MK040412/AlohaMini/docs/media/assembly/10.jpg

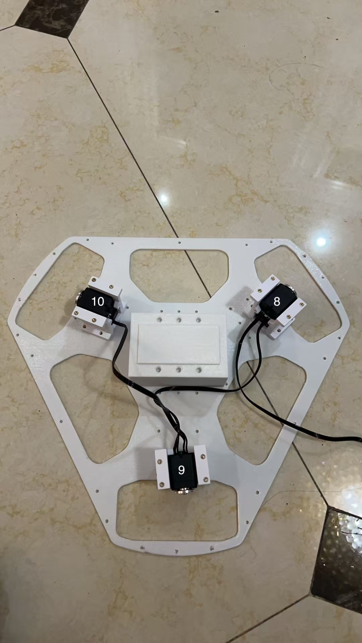
docs/media/assembly/10.jpg
