MK040412/AlohaMini/hardware/mobile_base/stl/O_Main_Assembly_Post4.stl

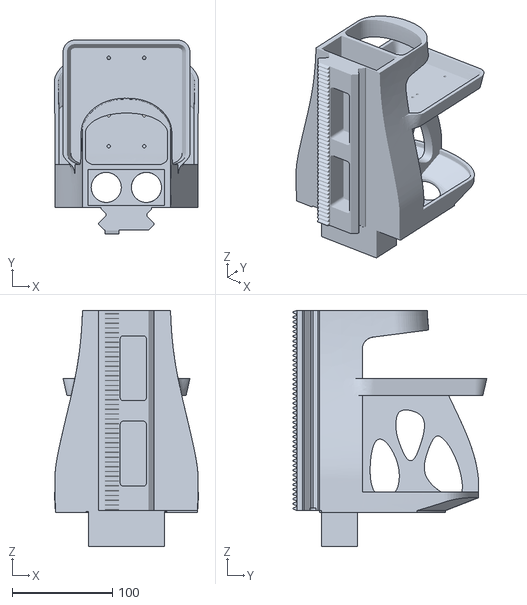
[picture p2: CAD file, 2025-12-03]
hardware/mobile_base/stl/O_Main_Assembly_Post4.stl
143.8 x 192.8 x 235.0
