MK040412/AlohaMini/hardware/mobile_base/step/O_Main_Assembly_Post3.stp

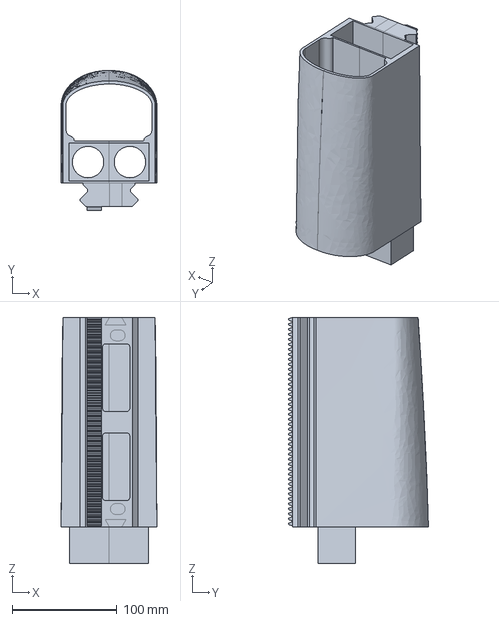
[picture p3: CAD file, 2025-11-27]
hardware/mobile_base/step/O_Main_Assembly_Post3.stp
91.5 x 133.6 x 235.0 mm
