MK040412/AlohaMini/hardware/mobile_base/step/OB_Main_Monitor_Connector.stp

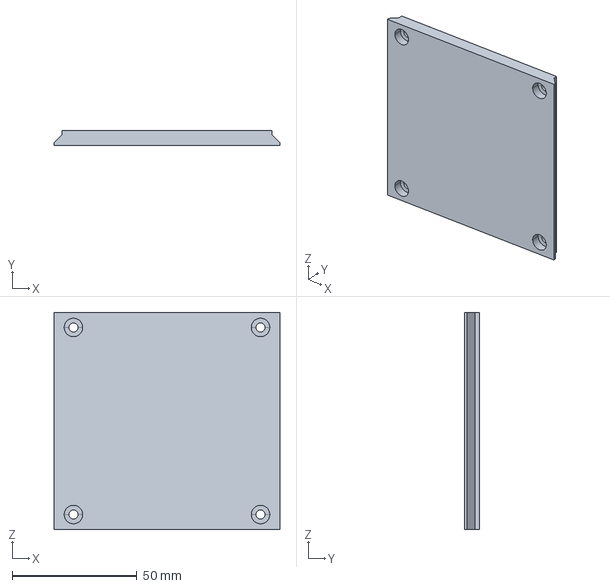
[picture p4: CAD file, 2025-11-27]
hardware/mobile_base/step/OB_Main_Monitor_Connector.stp
90.6 x 6.00 x 87.0 mm
