MK040412/AlohaMini/hardware/mobile_base/step/O_Main_Assembly_Post2.stp

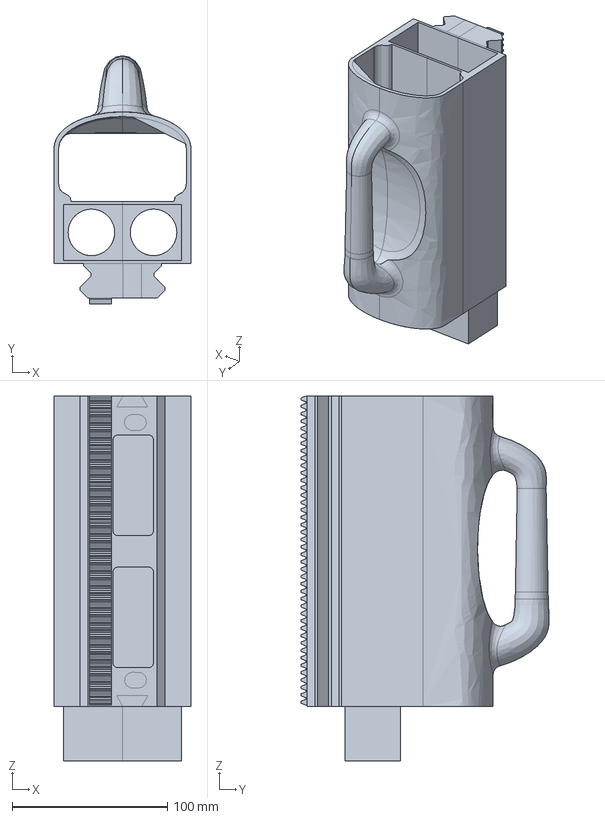
[picture p5: CAD file, 2025-11-27]
hardware/mobile_base/step/O_Main_Assembly_Post2.stp
88.1 x 159.9 x 235.0 mm
