MK040412/AlohaMini/hardware/mobile_base/step/O_Main_Assembly_Post1.stp

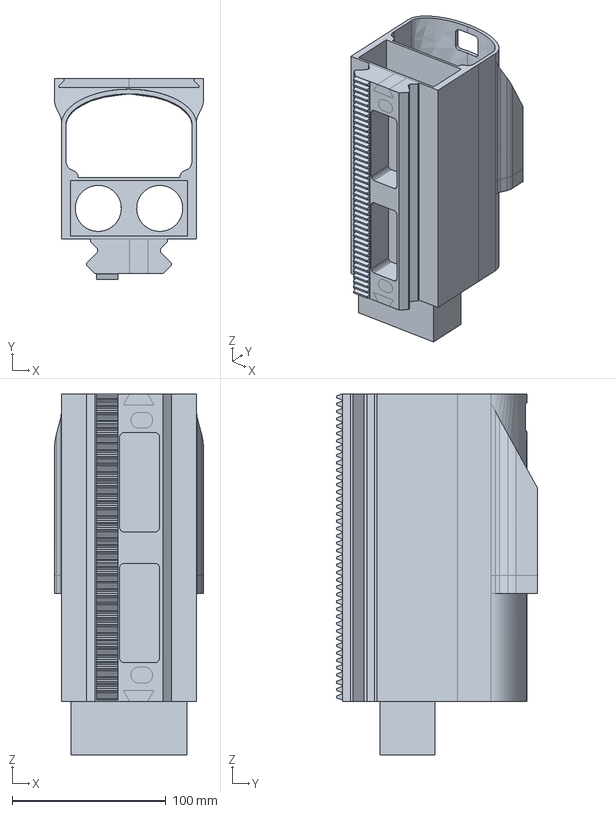
[picture p6: CAD file, 2025-11-27]
hardware/mobile_base/step/O_Main_Assembly_Post1.stp
97.0 x 130.7 x 235.0 mm
