MK040412/AlohaMini/hardware/mobile_base/step/O_Chassis_Dowel_Pin_12_37.stp

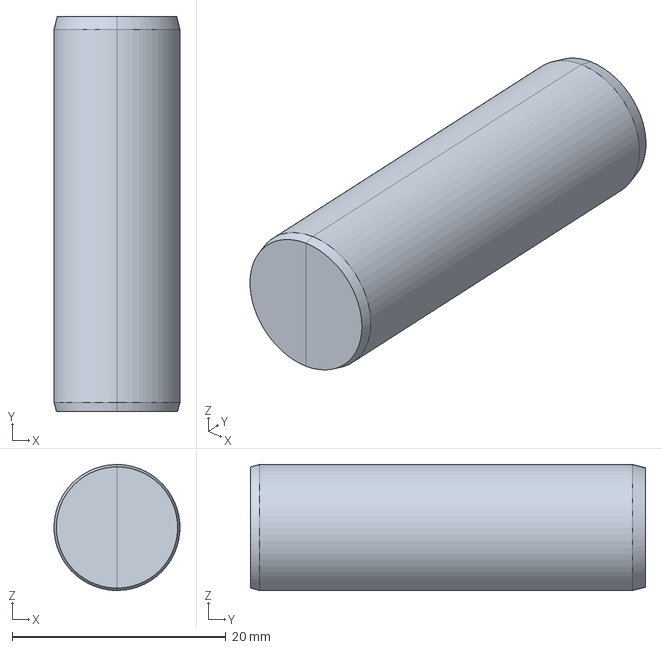
[picture p7: CAD file, 2025-11-27]
hardware/mobile_base/step/O_Chassis_Dowel_Pin_12_37.stp
11.8 x 37.0 x 11.8 mm
