MK040412/AlohaMini/maniskill/aloha_mini/meshes/left_link3.STL

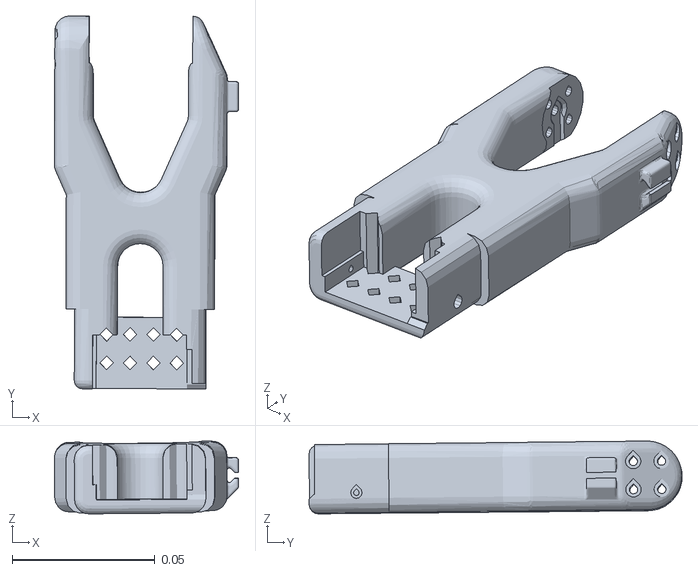
[picture p8: CAD file, 2025-12-24]
maniskill/aloha_mini/meshes/left_link3.STL
0.0646 x 0.131 x 0.0255
