MK040412/AlohaMini/hardware/mobile_base/step/OB_Z_Axis_Servo_Mount.stp

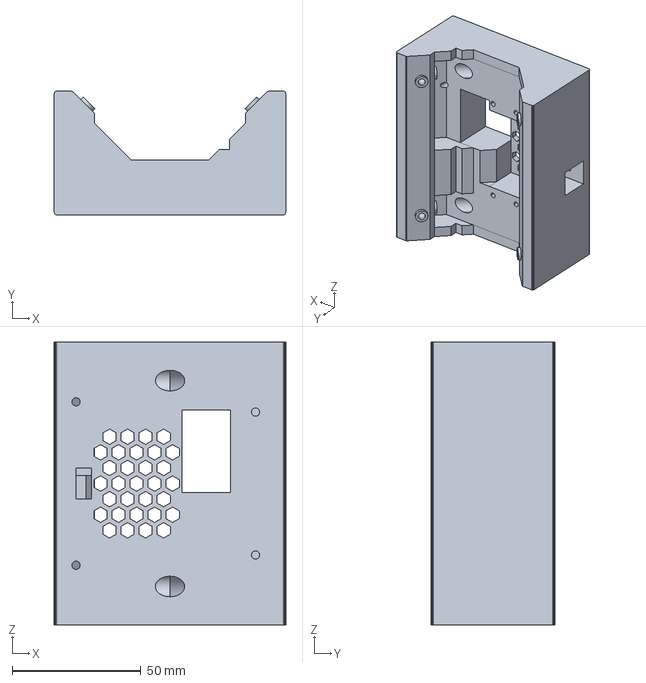
[picture p10: CAD file, 2025-11-27]
hardware/mobile_base/step/OB_Z_Axis_Servo_Mount.stp
90.0 x 48.0 x 110.0 mm
