MK040412/AlohaMini/maniskill/aloha_mini/meshes/wheel1.STL

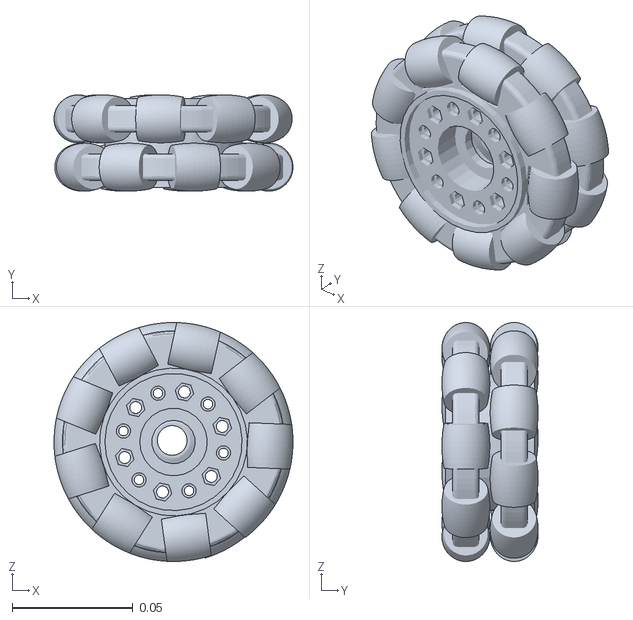
[picture p11: CAD file, 2025-12-24]
maniskill/aloha_mini/meshes/wheel1.STL
0.099 x 0.0399 x 0.099
