MK040412/AlohaMini/maniskill/assets/robots/aloha_mini/so100_meshes/Rotation_Pitch.stl.convex.stl

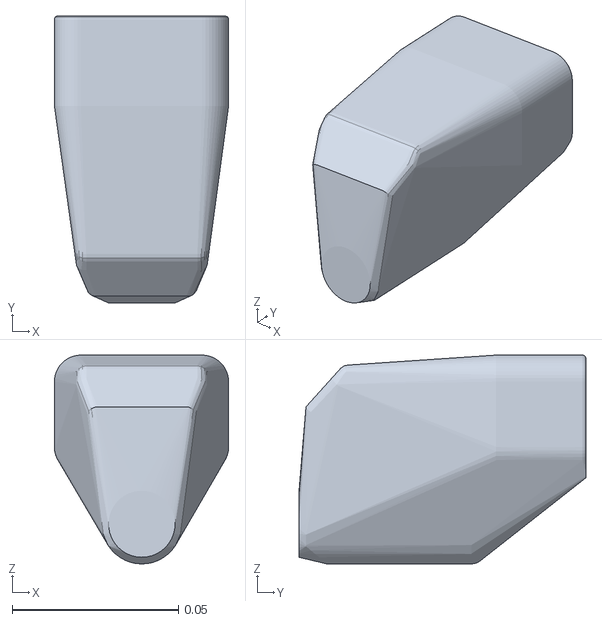
[picture p12: CAD file, 2026-01-14]
maniskill/assets/robots/aloha_mini/so100_meshes/Rotation_Pitch.stl.convex.stl
0.0524 x 0.0863 x 0.0628
