MK040412/AlohaMini/hardware/mobile_base/step/OB_Z_Axis_Bracket.stp

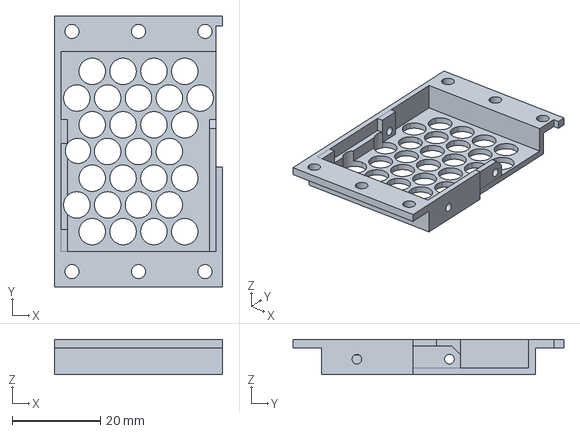
[picture p13: CAD file, 2025-11-27]
hardware/mobile_base/step/OB_Z_Axis_Bracket.stp
38.2 x 61.5 x 8.00 mm
