MK040412/AlohaMini/hardware/mobile_base/step/OB_T_Camera_Mount.stp

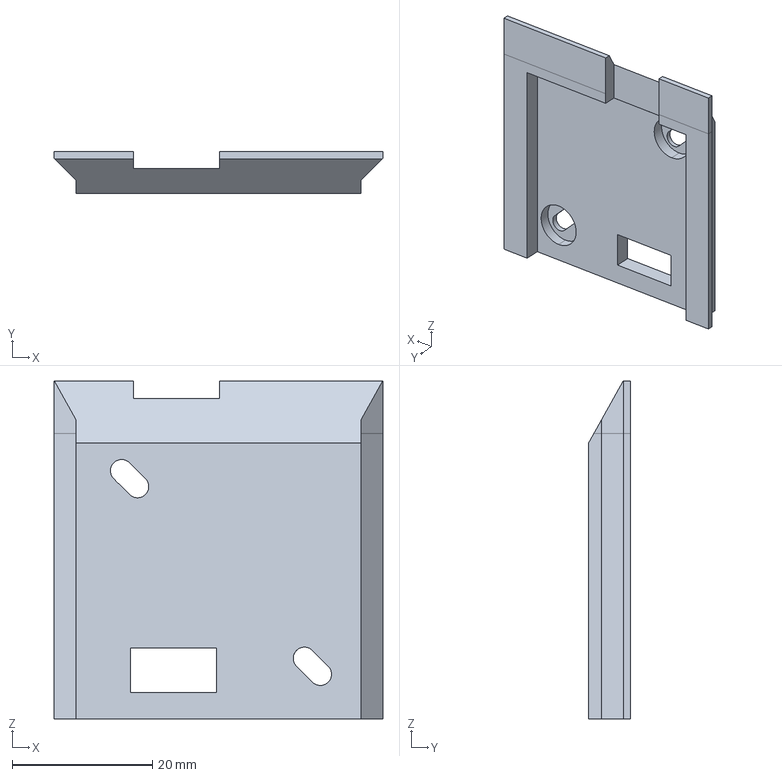
[picture p15: CAD file, 2025-11-27]
hardware/mobile_base/step/OB_T_Camera_Mount.stp
46.9 x 6.00 x 48.2 mm
