MK040412/AlohaMini/maniskill/aloha_mini/meshes/right_link6.STL

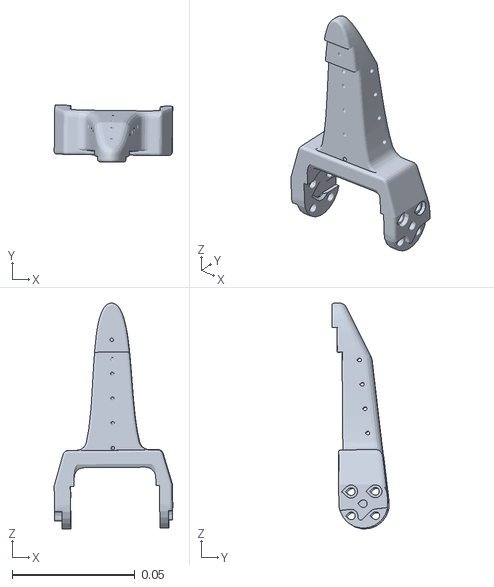
[picture p16: CAD file, 2025-12-24]
maniskill/aloha_mini/meshes/right_link6.STL
0.0483 x 0.0233 x 0.092
