MK040412/AlohaMini/maniskill/assets/robots/aloha_mini/so100_meshes/Lower_Arm.stl.convex.stl

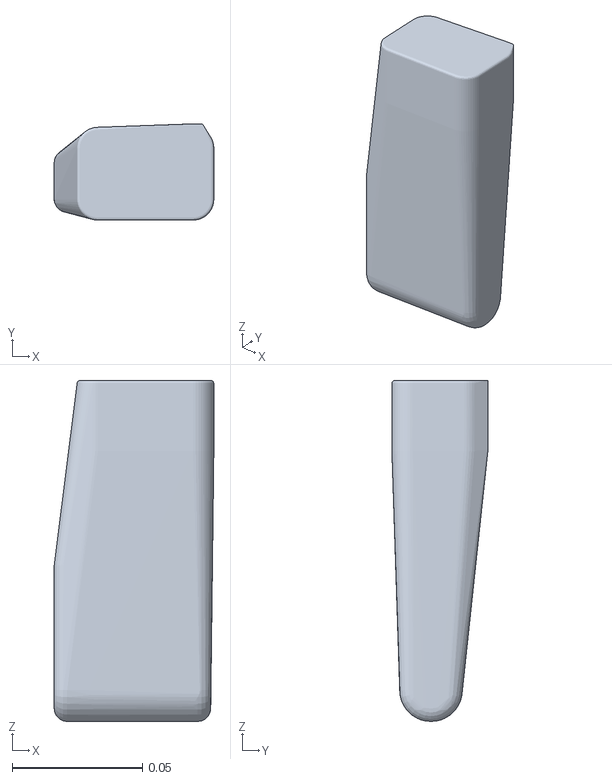
[picture p17: CAD file, 2026-01-14]
maniskill/assets/robots/aloha_mini/so100_meshes/Lower_Arm.stl.convex.stl
0.0612 x 0.0369 x 0.131
