MK040412/AlohaMini/maniskill/aloha_mini/meshes/right_base.STL

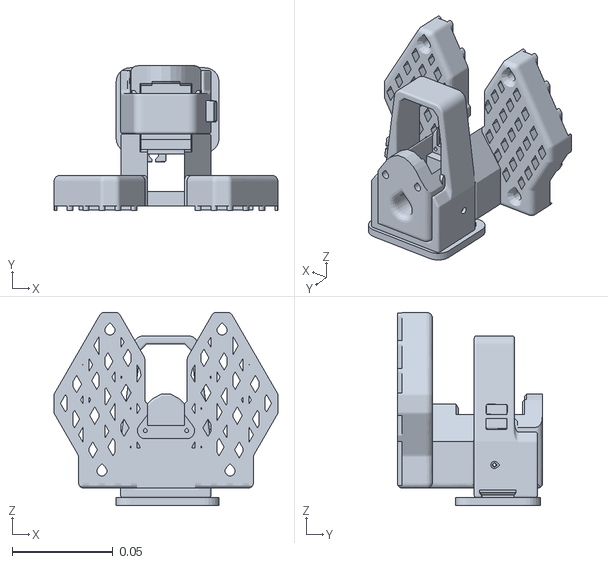
[picture p18: CAD file, 2025-12-24]
maniskill/aloha_mini/meshes/right_base.STL
0.111 x 0.072 x 0.0956
