MK040412/AlohaMini/maniskill/aloha_mini/meshes/left_link5.STL

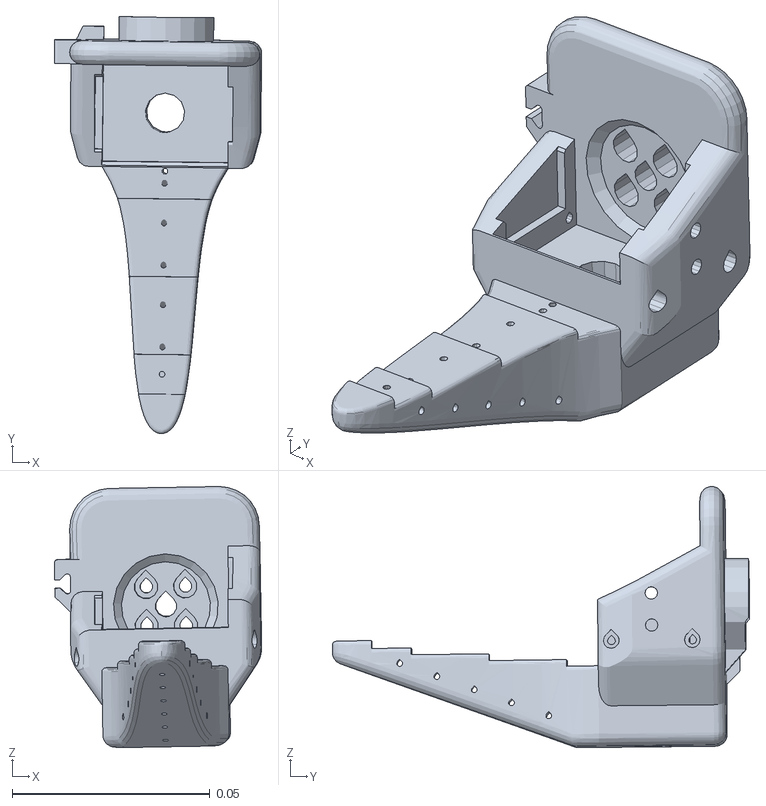
[picture p20: CAD file, 2025-12-24]
maniskill/aloha_mini/meshes/left_link5.STL
0.0524 x 0.105 x 0.066
