MK040412/AlohaMini/hardware/mobile_base/step/OB_Chassis_Side_Panel.stp

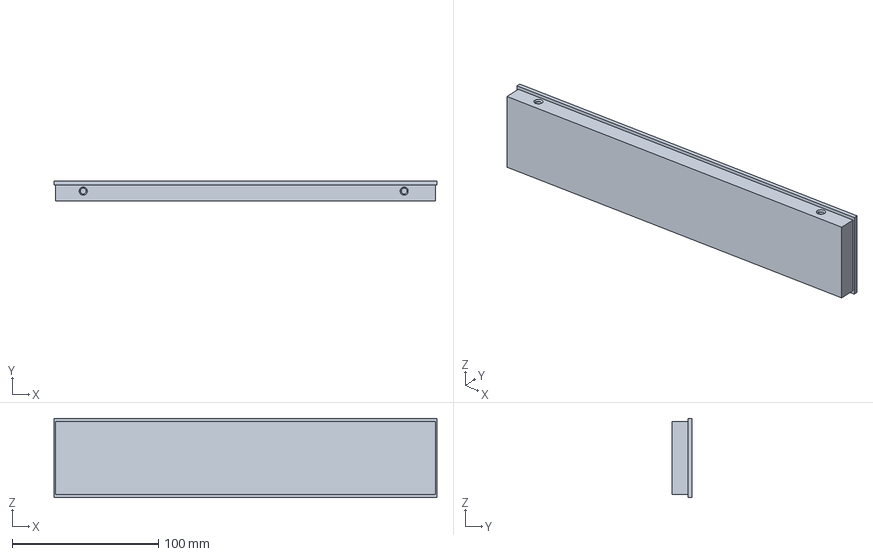
[picture p21: CAD file, 2025-11-27]
hardware/mobile_base/step/OB_Chassis_Side_Panel.stp
262.2 x 14.0 x 54.2 mm
