MK040412/AlohaMini/maniskill/aloha_mini/meshes/right_link4.STL

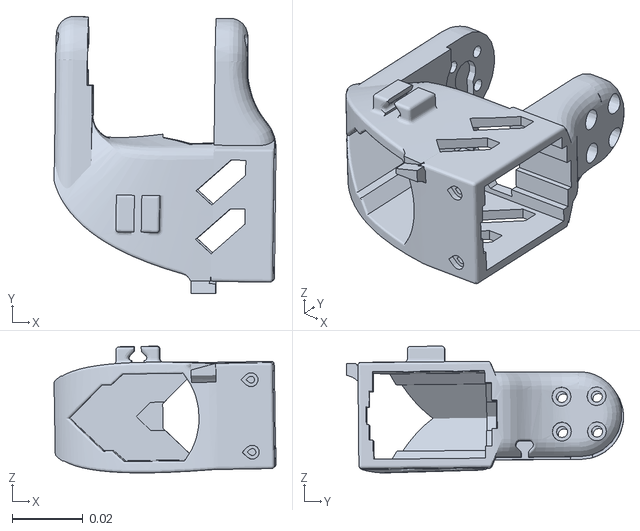
[picture p22: CAD file, 2025-12-24]
maniskill/aloha_mini/meshes/right_link4.STL
0.0628 x 0.0785 x 0.0359
