MK040412/AlohaMini/maniskill/assets/robots/aloha_mini/so100_meshes/Fixed_Jaw_part2.ply.convex.stl

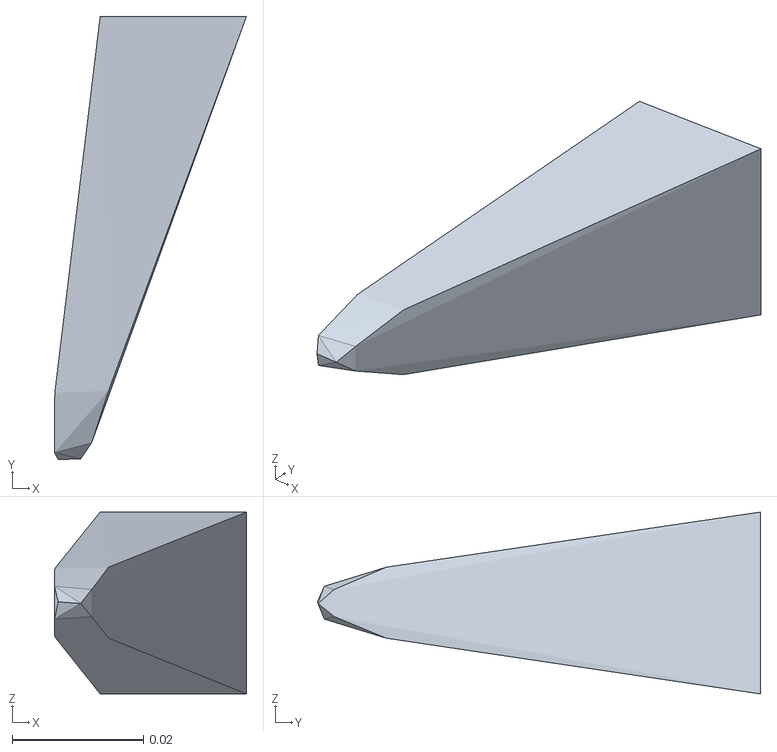
[picture p23: CAD file, 2026-01-14]
maniskill/assets/robots/aloha_mini/so100_meshes/Fixed_Jaw_part2.ply.convex.stl
0.0292 x 0.0675 x 0.0277
