MK040412/AlohaMini/hardware/mobile_base/step/O_Chassis_Lower_Plate.stp

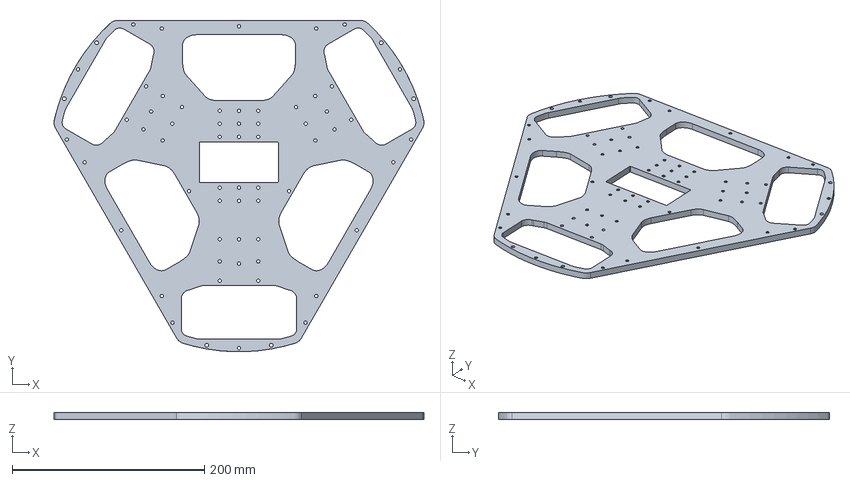
[picture p24: CAD file, 2025-11-27]
hardware/mobile_base/step/O_Chassis_Lower_Plate.stp
384.5 x 344.3 x 7.00 mm
