MK040412/AlohaMini/maniskill/aloha_mini/meshes/right_link2.STL

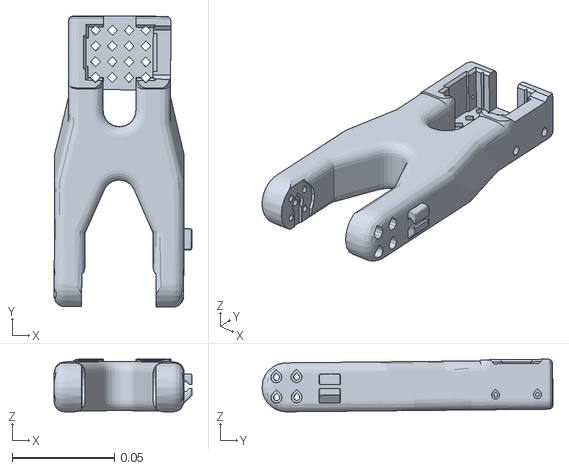
[picture p25: CAD file, 2025-12-24]
maniskill/aloha_mini/meshes/right_link2.STL
0.0674 x 0.142 x 0.0258
