MK040412/AlohaMini/maniskill/assets/robots/aloha_mini/so100_meshes/Rotation_Pitch_Motor.stl

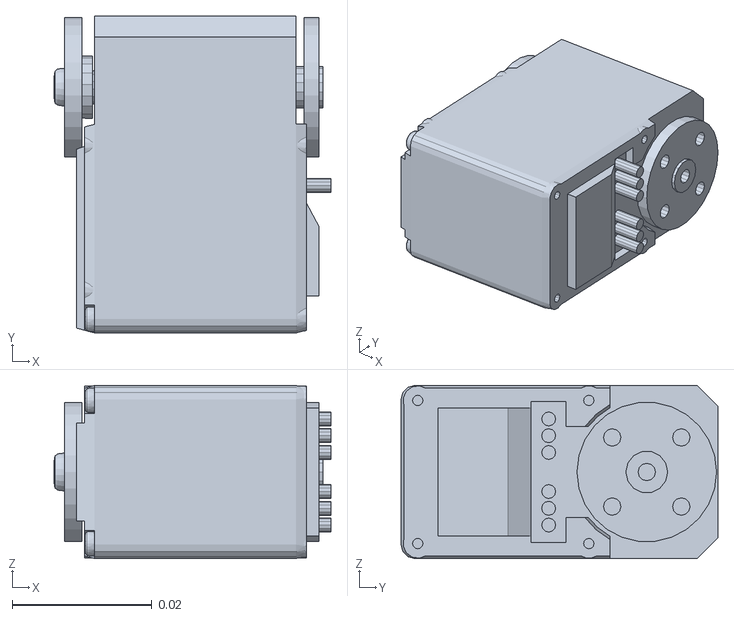
[picture p26: CAD file, 2026-01-14]
maniskill/assets/robots/aloha_mini/so100_meshes/Rotation_Pitch_Motor.stl
0.0396 x 0.0454 x 0.0248
