MK040412/AlohaMini/hardware/mobile_base/step/OB_Chassis_Bearing_Cover.stp

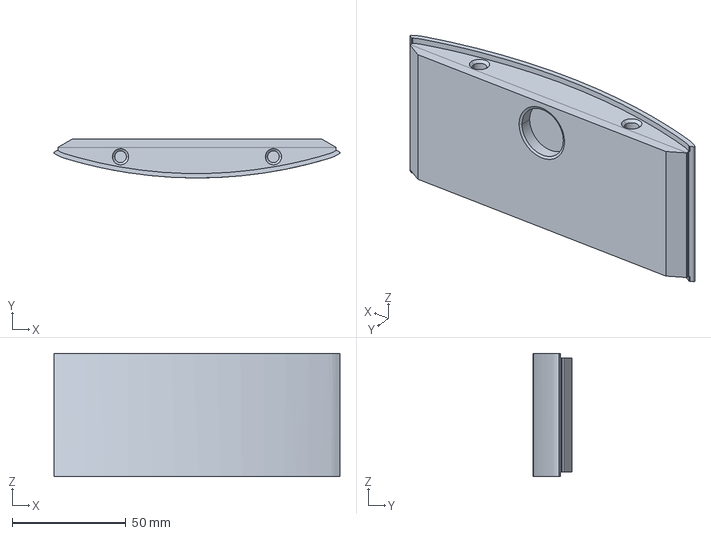
[picture p27: CAD file, 2025-11-27]
hardware/mobile_base/step/OB_Chassis_Bearing_Cover.stp
125.5 x 17.1 x 54.2 mm
