MK040412/AlohaMini/hardware/mobile_base/step/OB_Chassis_Wheel_Axle_Connector.stp

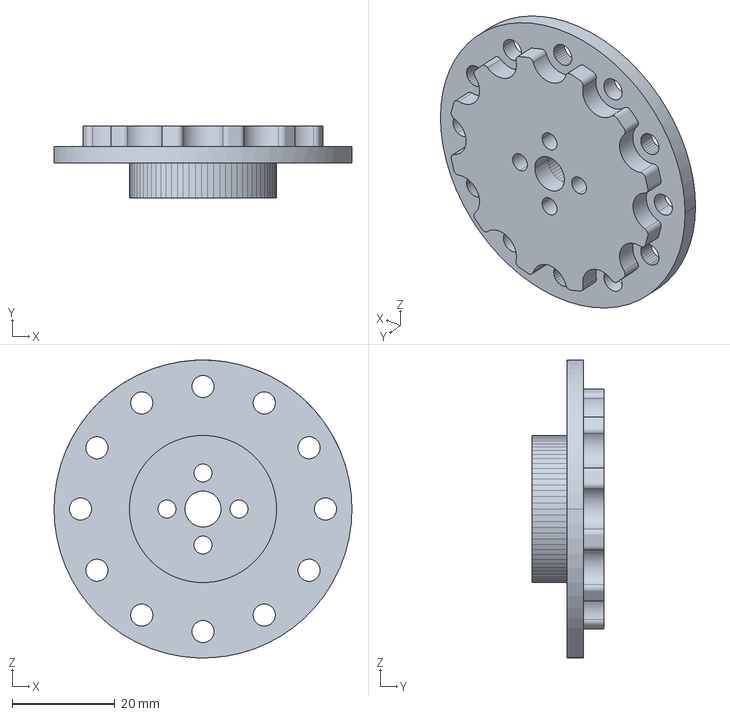
[picture p29: CAD file, 2025-11-27]
hardware/mobile_base/step/OB_Chassis_Wheel_Axle_Connector.stp
57.9 x 14.0 x 57.9 mm
