MK040412/AlohaMini/maniskill/aloha_mini/meshes/left_link1.STL

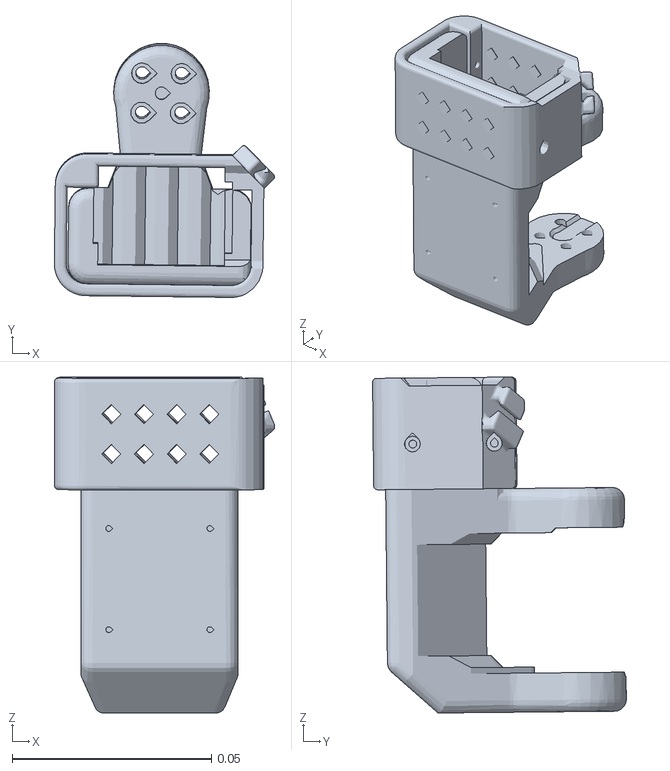
[picture p30: CAD file, 2025-12-24]
maniskill/aloha_mini/meshes/left_link1.STL
0.0553 x 0.0638 x 0.0844
