MK040412/AlohaMini/hardware/mobile_base/step/OB_Chassis_Servo_Mount.stp

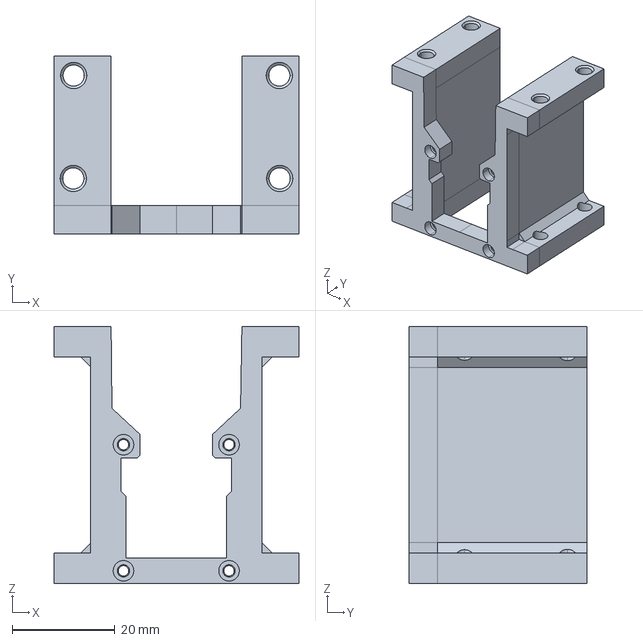
[picture p31: CAD file, 2025-11-27]
hardware/mobile_base/step/OB_Chassis_Servo_Mount.stp
47.6 x 34.5 x 50.0 mm
