MK040412/AlohaMini/maniskill/assets/robots/aloha_mini/so100_meshes/Moving_Jaw.stl

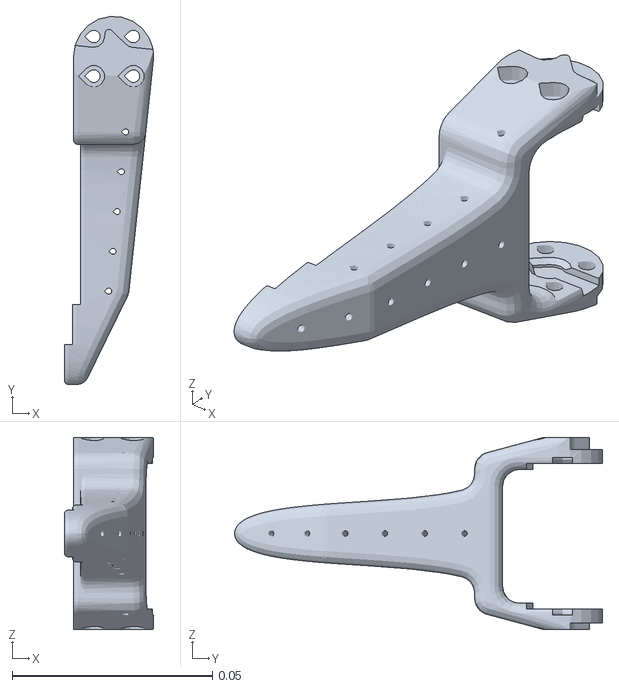
[picture p32: CAD file, 2026-01-14]
maniskill/assets/robots/aloha_mini/so100_meshes/Moving_Jaw.stl
0.0223 x 0.092 x 0.048
