MK040412/AlohaMini/hardware/mobile_base/step/O_T_Connector_Cross_Bar.stp

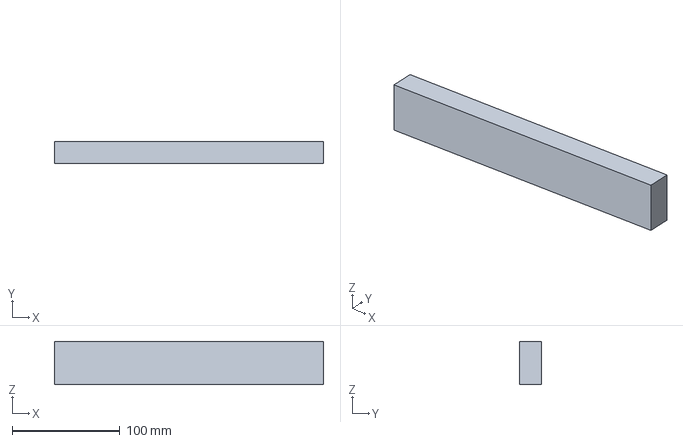
[picture p33: CAD file, 2025-11-27]
hardware/mobile_base/step/O_T_Connector_Cross_Bar.stp
250.0 x 20.0 x 40.0 mm
