MK040412/AlohaMini/maniskill/aloha_mini/meshes/wheel3.STL

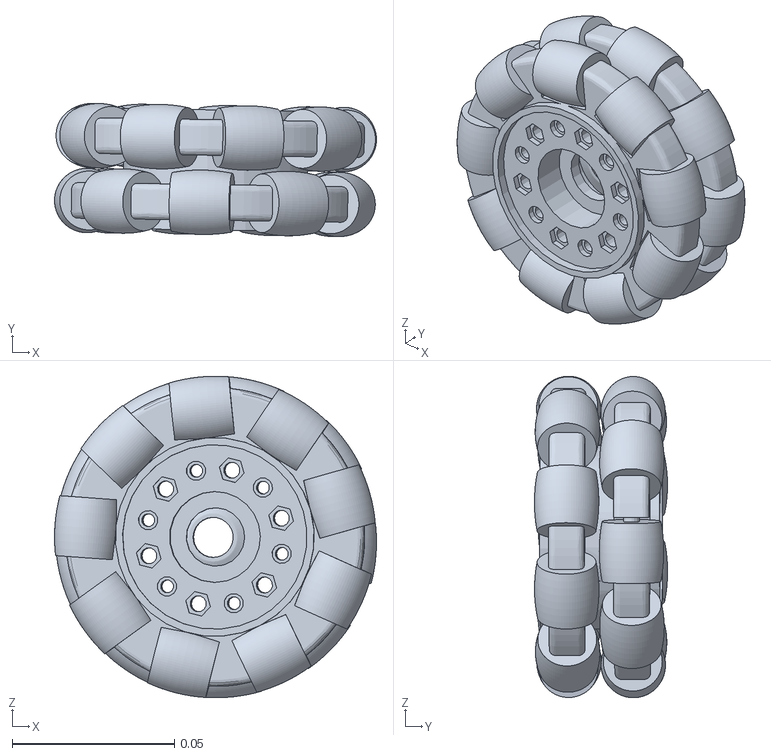
[picture p34: CAD file, 2025-12-24]
maniskill/aloha_mini/meshes/wheel3.STL
0.0991 x 0.041 x 0.099
