MK040412/AlohaMini/maniskill/assets/robots/aloha_mini/so100_meshes/Wrist_Pitch_Roll_Motor.stl.convex.stl

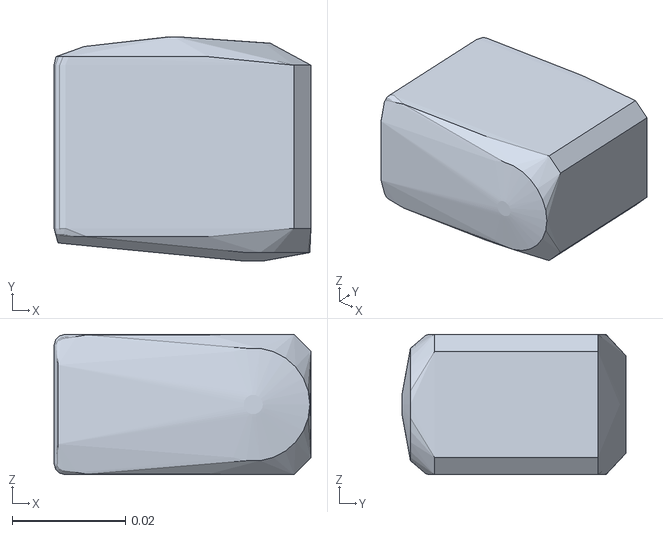
[picture p35: CAD file, 2026-01-14]
maniskill/assets/robots/aloha_mini/so100_meshes/Wrist_Pitch_Roll_Motor.stl.convex.stl
0.0454 x 0.0396 x 0.0248
