MK040412/AlohaMini/hardware/mobile_base/step/OB_Chassis_Shaft_Sleeve_12_24.stp

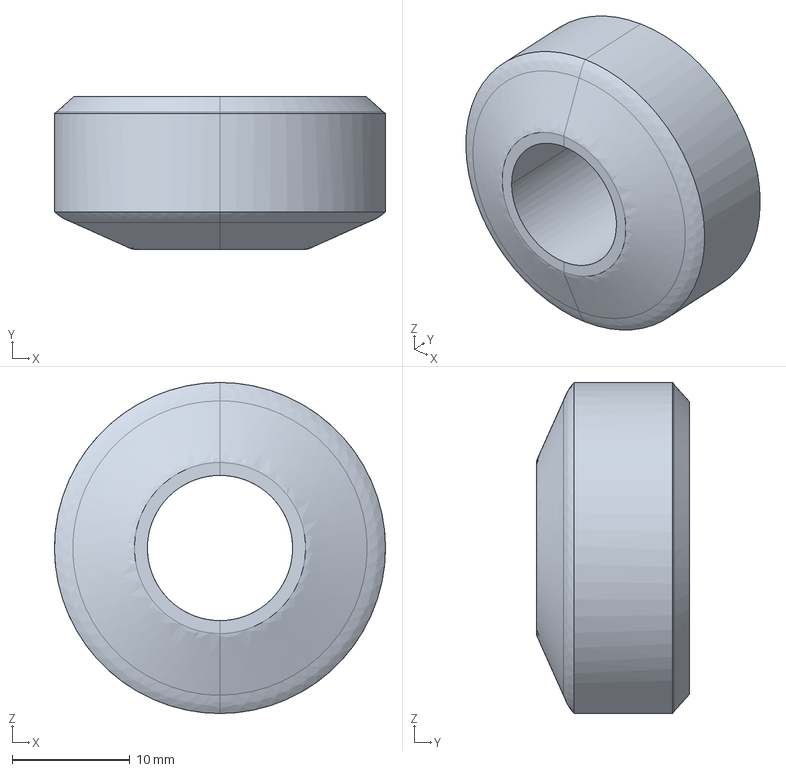
[picture p36: CAD file, 2025-11-27]
hardware/mobile_base/step/OB_Chassis_Shaft_Sleeve_12_24.stp
28.1 x 13.0 x 28.1 mm
