MK040412/AlohaMini/hardware/mobile_base/step/OB_T_Connector_Middle.stp

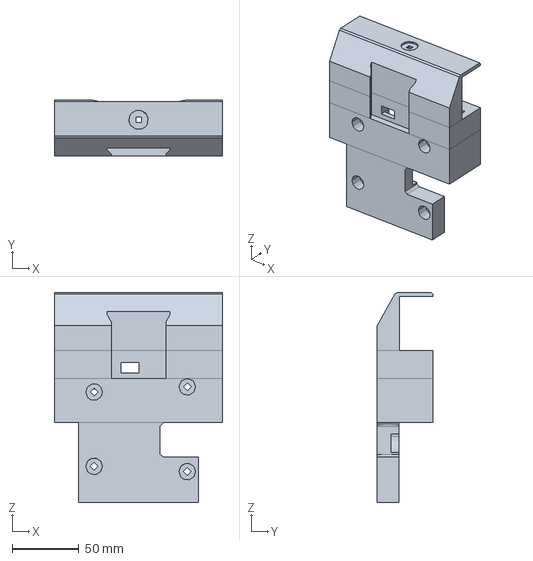
[picture p37: CAD file, 2025-11-27]
hardware/mobile_base/step/OB_T_Connector_Middle.stp
126.0 x 41.6 x 157.2 mm
