MK040412/AlohaMini/maniskill/assets/robots/aloha_mini/so100_meshes/Fixed_Jaw.stl.convex.stl

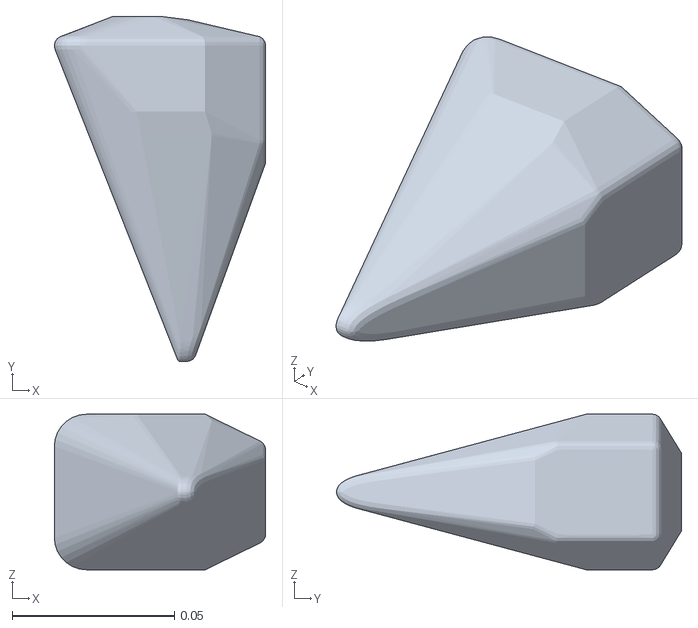
[picture p38: CAD file, 2026-01-14]
maniskill/assets/robots/aloha_mini/so100_meshes/Fixed_Jaw.stl.convex.stl
0.0652 x 0.106 x 0.048
