MK040412/AlohaMini/hardware/mobile_base/step/OB_T_Connector_Left.stp

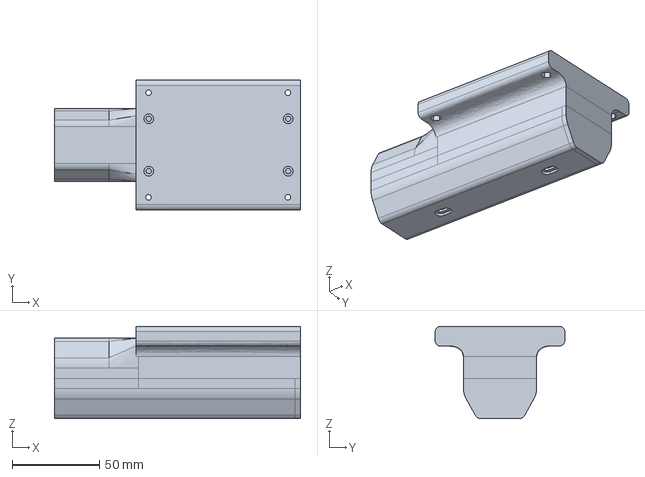
[picture p39: CAD file, 2025-11-27]
hardware/mobile_base/step/OB_T_Connector_Left.stp
141.1 x 74.4 x 53.1 mm
