MK040412/AlohaMini/maniskill/assets/robots/aloha_mini/so100_meshes/Moving_Jaw_part3.ply

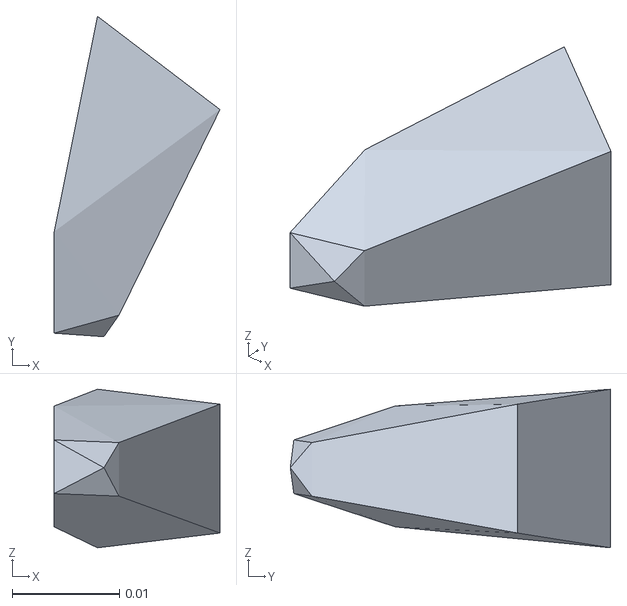
[picture p41: CAD file, 2026-01-14]
maniskill/assets/robots/aloha_mini/so100_meshes/Moving_Jaw_part3.ply
0.0155 x 0.0298 x 0.0148
