MK040412/AlohaMini/hardware/mobile_base/step/O_Chassis_Upper_Plate.stp

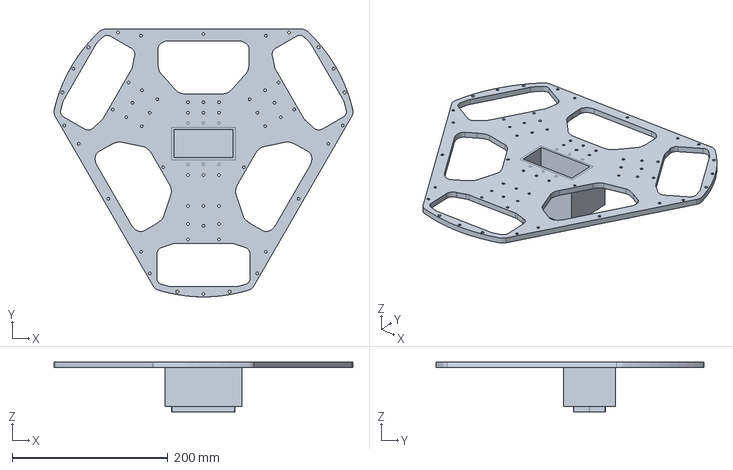
[picture p42: CAD file, 2025-11-27]
hardware/mobile_base/step/O_Chassis_Upper_Plate.stp
384.5 x 344.3 x 64.0 mm
