MK040412/AlohaMini/maniskill/aloha_mini/meshes/vertical_link.STL

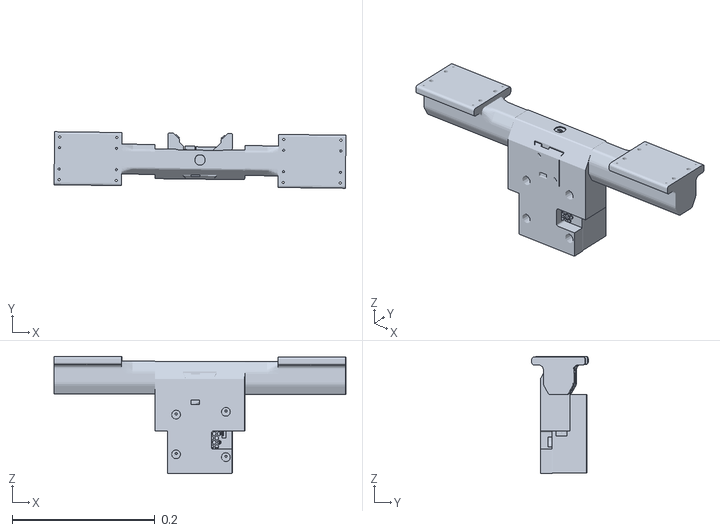
[picture p43: CAD file, 2025-12-24]
maniskill/aloha_mini/meshes/vertical_link.STL
0.409 x 0.0793 x 0.164
