MK040412/AlohaMini/hardware/mobile_base/step/OB_Top_Camera_Back_Cover.stp

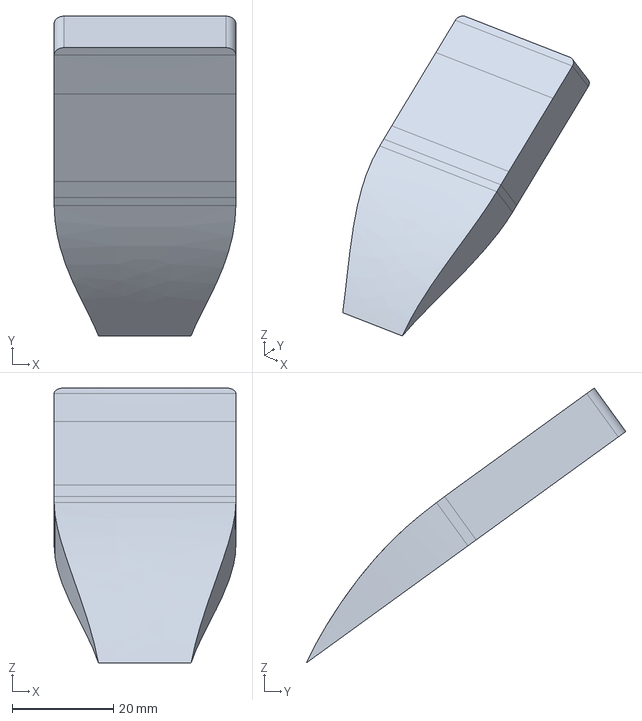
[picture p45: CAD file, 2025-11-27]
hardware/mobile_base/step/OB_Top_Camera_Back_Cover.stp
35.9 x 63.2 x 54.4 mm
