MK040412/AlohaMini/maniskill/assets/robots/aloha_mini/so100_meshes/Upper_Arm.stl

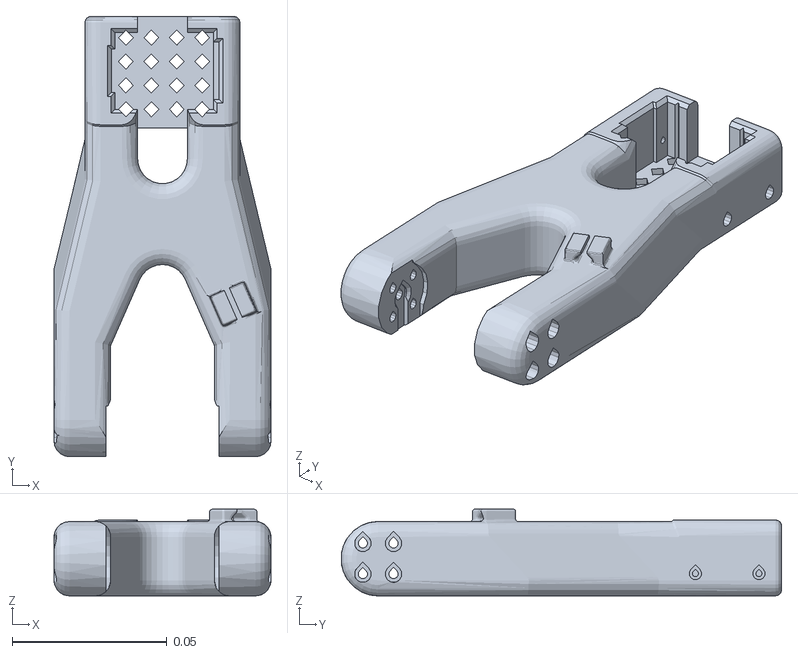
[picture p46: CAD file, 2026-01-14]
maniskill/assets/robots/aloha_mini/so100_meshes/Upper_Arm.stl
0.07 x 0.142 x 0.028
