MK040412/AlohaMini/hardware/mobile_base/step/OB_Z_Axis_Servo_Gear.stp

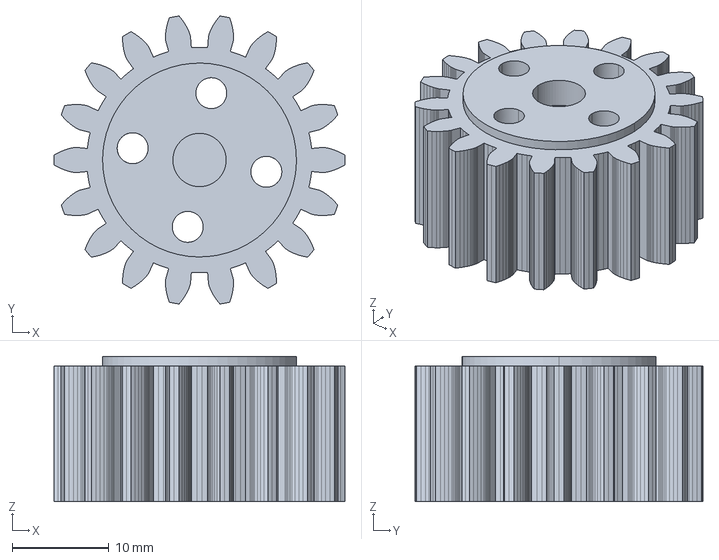
[picture p47: CAD file, 2025-11-27]
hardware/mobile_base/step/OB_Z_Axis_Servo_Gear.stp
30.0 x 29.7 x 15.0 mm
