MK040412/AlohaMini/maniskill/assets/robots/aloha_mini/so100_meshes/Wrist_Pitch_Roll.stl.convex.stl

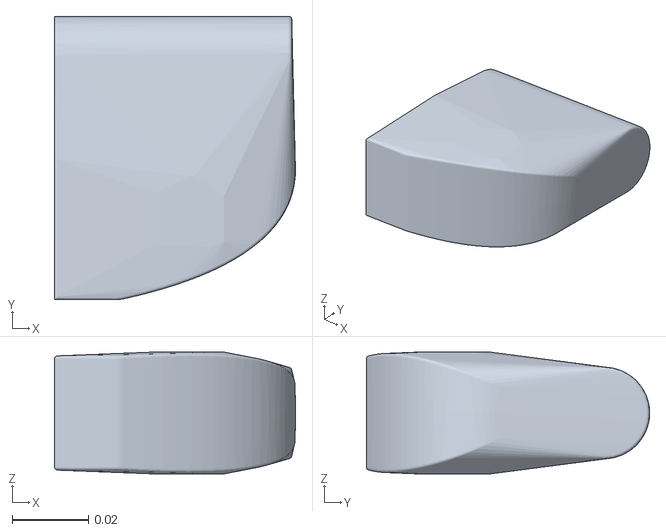
[picture p48: CAD file, 2026-01-14]
maniskill/assets/robots/aloha_mini/so100_meshes/Wrist_Pitch_Roll.stl.convex.stl
0.0633 x 0.0744 x 0.032
