MK040412/AlohaMini/maniskill/assets/robots/aloha_mini/so100_meshes/Fixed_Jaw_part1.ply.convex.stl

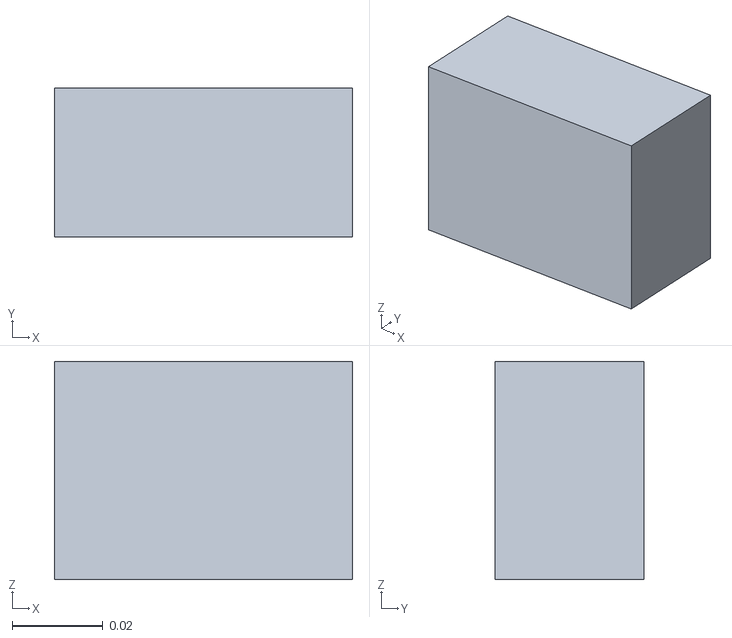
[picture p49: CAD file, 2026-01-14]
maniskill/assets/robots/aloha_mini/so100_meshes/Fixed_Jaw_part1.ply.convex.stl
0.0656 x 0.0328 x 0.048
