MK040412/AlohaMini/maniskill/assets/robots/aloha_mini/so100_meshes/Moving_Jaw_part2.ply

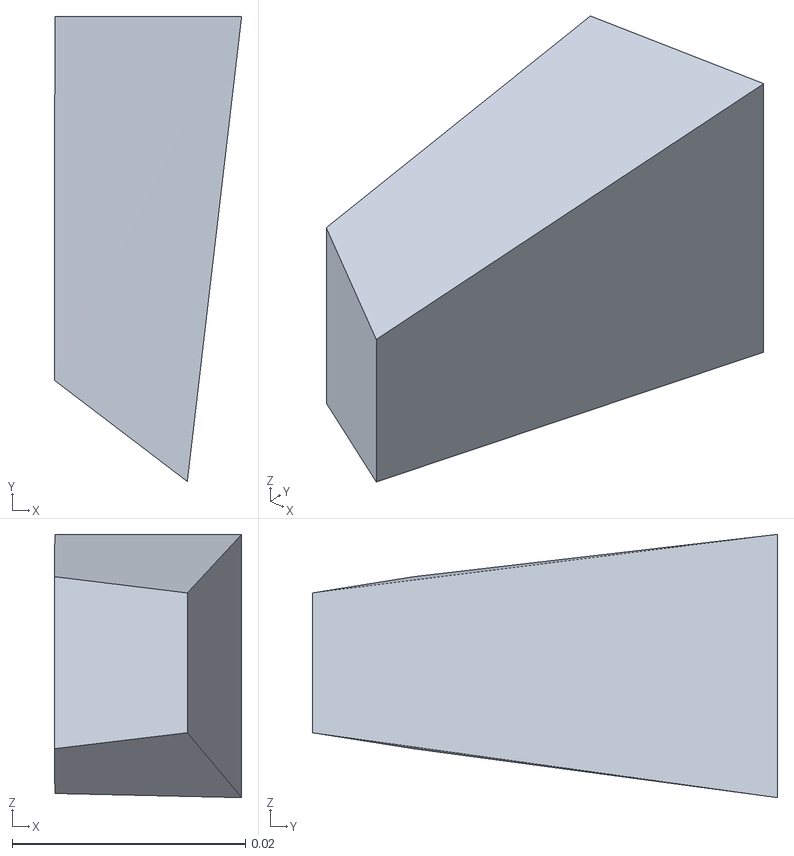
[picture p50: CAD file, 2026-01-14]
maniskill/assets/robots/aloha_mini/so100_meshes/Moving_Jaw_part2.ply
0.0161 x 0.0399 x 0.0226
