MK040412/AlohaMini/maniskill/assets/robots/aloha_mini/so100_meshes/Moving_Jaw_part1.ply

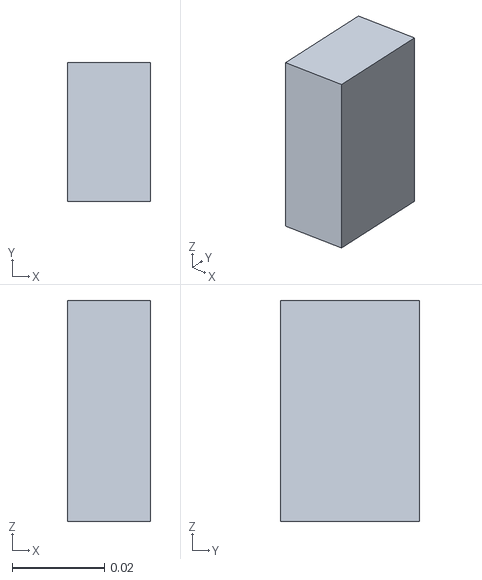
[picture p51: CAD file, 2026-01-14]
maniskill/assets/robots/aloha_mini/so100_meshes/Moving_Jaw_part1.ply
0.018 x 0.03 x 0.0478
