MK040412/AlohaMini/maniskill/assets/robots/aloha_mini/so100_meshes/Base.stl

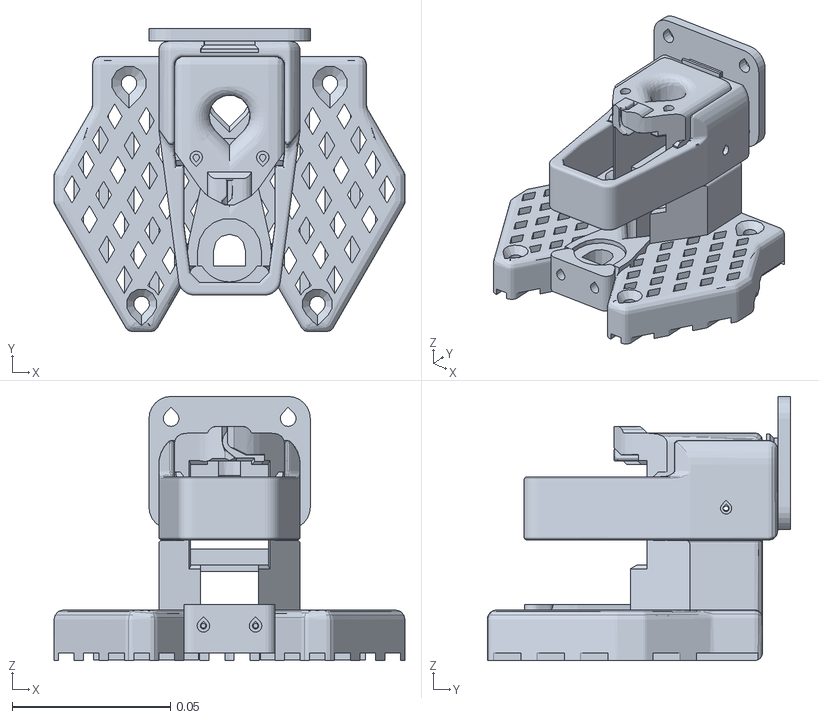
[picture p53: CAD file, 2026-01-14]
maniskill/assets/robots/aloha_mini/so100_meshes/Base.stl
0.111 x 0.0959 x 0.0835
