MK040412/AlohaMini/(list of files, cad)

Other CAD files:
maniskill/aloha_mini/meshes/wheel2.STL
maniskill/assets/robots/aloha_mini/so100_meshes/Upper_Arm_Motor.stl.convex.stl
maniskill/assets/robots/aloha_mini/so100_meshes/Fixed_Jaw_Motor.stl.convex.stl
maniskill/assets/robots/aloha_mini/so100_meshes/Fixed_Jaw_part2.ply
maniskill/assets/robots/aloha_mini/so100_meshes/Lower_Arm_Motor.stl.convex.stl
maniskill/aloha_mini/meshes/left_base.STL
maniskill/assets/robots/aloha_mini/so100_meshes/Lower_Arm_Motor.stl
hardware/mobile_base/step/OB_T_Connector_Right.stp
maniskill/assets/robots/aloha_mini/so100_meshes/Upper_Arm_Motor.stl
maniskill/assets/robots/aloha_mini/so100_meshes/Moving_Jaw_part1.ply.convex.stl
maniskill/assets/robots/aloha_mini/so100_meshes/Fixed_Jaw_Motor.stl
maniskill/assets/robots/aloha_mini/so100_meshes/Moving_Jaw_part2.ply.convex.stl
maniskill/assets/robots/aloha_mini/so100_meshes/Moving_Jaw_part3.ply.convex.stl
maniskill/assets/robots/aloha_mini/so100_meshes/Rotation_Pitch_Motor.stl.convex.stl
maniskill/assets/robots/aloha_mini/so100_meshes/Base_Motor.stl
maniskill/assets/robots/aloha_mini/so100_meshes/Fixed_Jaw_part1.ply
