MK040412/AlohaMini/(commit log)

2025-11-13 fix assembly guide
2025-11-27 feat(cad): add STEP files
    [OB_Chassis_Bearing_Cover.stp, OB_Chassis_Servo_Mount.stp, OB_Chassis_Shaft_Sleeve_12_24.stp, OB_Chassis_Side_Panel.stp, OB_Chassis_Wheel_Axle_Connector.stp, OB_Main_Monitor_Connector.stp, OB_T_Camera_Mount.stp, OB_T_Connector_Left.stp]
2025-11-29 docs(bom): update BOM details
2025-12-01 docs: update bom
2025-12-03 chore: update O_Main_Assembly_Post4.stl with latest revision
    [O_Main_Assembly_Post4.stl]
2025-12-18 docs(readme): update Updates section for URDF and simulation
2025-12-24 feat(maniskill): add ManiSkill3 integration with virtual mobile base
    - Add AlohaMini robot agent (physical wheels, fixed, and virtual base variants)
    - Add aloha_mini_virtual with prismatic X/Y + rotation joints (XLeRobot-style)
    - Include URDF files and STL meshes
    - Add ReplicaCAD scene builder support
    - Create install.py for easy installation into ManiSkill
    - Add demo scripts: demo_virtual_base.py, demo_ee_keyboard.py, run_replicacad.py
    - Include comprehensive README with installation and usage instructions
    The virtual base variant (aloha_mini_virtual) is recommended for stable navigation.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
    [aloha_mini.urdf, aloha_mini_virtual_base.urdf, left_base.STL, left_link1.STL, left_link2.STL, left_link3.STL, left_link4.STL, left_link5.STL]
2025-12-24 feat(controls): change keyboard to FPS style and add TechReport
    - Change keyboard controls to FPS style (W/S forward, A/D rotate)
    - Add comprehensive TechReport.md with architecture diagrams
    - Include codebase structure, data flow, and design rationale
    - Update all demo scripts and README files with new controls
    Controls:
    W/S: Forward/Backward
    A/D: Rotate Left/Right
    Q/E: Strafe Left/Right
    R/F: Lift Up/Down
2025-12-28 fix(controls): standardize FPS keyboard layout and fix lift limits
    - Keyboard controls: W/S forward/back, A/D strafe, Q/E rotate
    - Fix vertical_move joint limit from 0-0.15m to 0-0.6m (60cm travel)
    - Add camera follow robot from above in demo scripts
    - Update all documentation with correct controls
    [aloha_mini_virtual_base.urdf]
2025-12-31 feat(teleop): add first-person camera view and CPU test support
    - Fix first-person camera in aloha_mini_virtual.py:
    - Roll=180°, pitch=-45°, yaw=90° for correct orientation
    - Both arms visible at bottom corners
    - Looking down at workspace with room ahead
    - Mounted on vertical_link for stable view
    - Add teleop module with:
    - Keyboard controller for robot navigation
    - IK kinematics for arm control
    - VR WebSocket server for VR teleoperation
    - Web UI for VR headset interface
    - CPU-compatible test script (test_firstperson_cpu.py)
2026-01-03 fix(camera): update first-person view to top-down perspective
    - Position camera 1.45m above base_link
    - Rotation: rx=90°, ry=90° (XYZ euler) to look straight down
    - Both arms visible on left and right sides
    - Clear view of workspace below
2026-01-03 feat(teleop): add pygame-based teleoperation demo
    - WASD: Base movement (forward/back/strafe)
    - QE: Base rotation
    - ZX: Lift up/down
    - IJKL/UO: Left arm control
    - Arrow keys/PgUp/PgDn: Right arm control
    - G/H: Toggle grippers
    - R: Reset environment
    - ESC: Quit
    Usage: python teleop/demo_pygame_teleop.py [--gpu]
    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
2026-01-03 feat(teleop): add VR teleoperation with camera streaming
    - demo_vr_teleop_stream.py: Stream robot camera to web browser
    - Real-time JPEG streaming via WebSocket
    - WebXR VR controller support
    - Thumbstick controls for base movement and lift
    - Trigger controls for grippers
    - Web UI shows first-person camera view from robot
    - Works on VR headsets (Quest, etc.) via HTTPS
    Usage: python teleop/demo_vr_teleop_stream.py [--gpu]
    Then open https://<ip>:8443 in VR headset browser
2026-01-03 fix(vr): add WebGL rendering for camera view in VR mode
    - Fix VR session duplicate error: check if session exists before starting
    - Add WebGL initialization with xrCompatible context
    - Create vertex/fragment shaders for full-screen textured quad
    - Update camera texture from WebSocket stream
    - Render camera texture to VR headset display in XR frame loop
    Now VR mode shows the robot's camera view instead of black screen.
2026-01-14 refactor: update maniskill to use SO100 arms with improved teleop
    Major changes:
    - Replace AlohaMini/AlohaMiniVirtual with AlohaMiniSO100V2
    - Use SO100 arm mesh files instead of custom STL meshes
    - Update README.md with current codebase structure
    - Add IK-based keyboard teleoperation (demo_teleop.py)
    - Add VR teleoperation with camera streaming
    [Base.stl, Base.stl.convex.stl, Base_Motor.stl, Base_Motor.stl.convex.stl, Fixed_Jaw.stl, Fixed_Jaw.stl.convex.stl, Fixed_Jaw_Motor.stl, Fixed_Jaw_Motor.stl.convex.stl]
2026-01-15 TechReport.md 삭제
2026-01-27 fix: use ASSET_DIR for urdf_path instead of relative path
    The relative path breaks when agent files are copied to ManiSkill's
    installation directory. Now uses ~/.maniskill/data/robots/aloha_mini/
    which is where install.py copies the URDF files.
